kenberland/lime-scooter/img/IMG_2955.jpeg

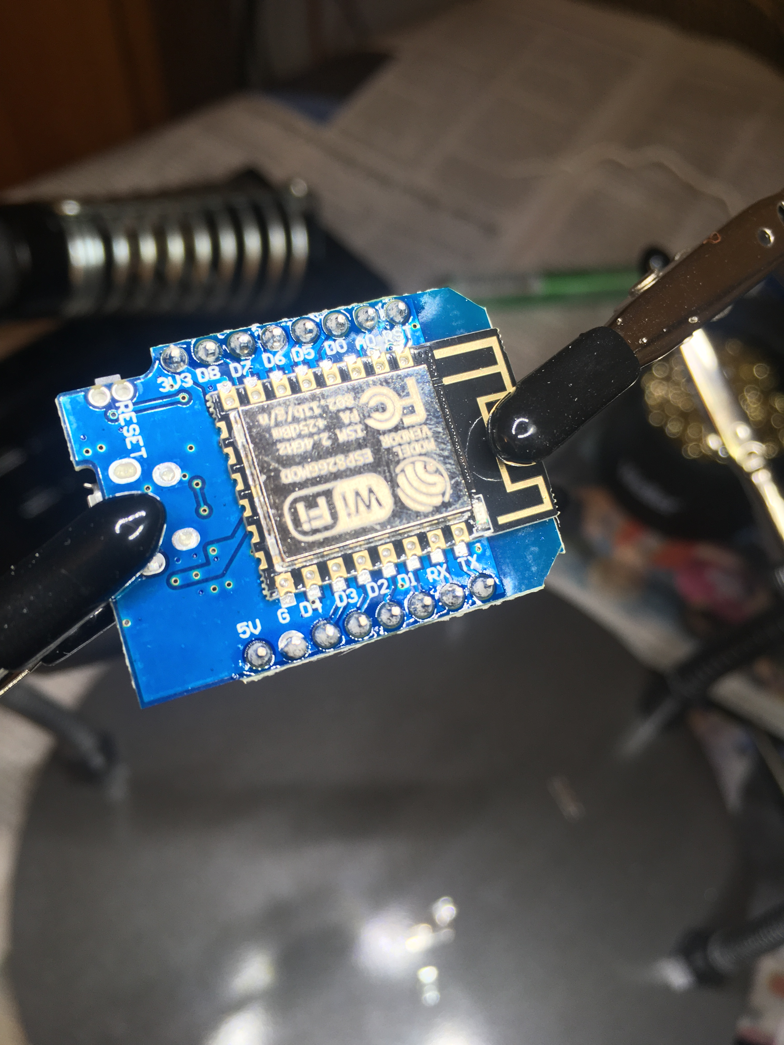
img/IMG_2955.jpeg
