kenberland/lime-scooter/img/IMG_3039.jpg

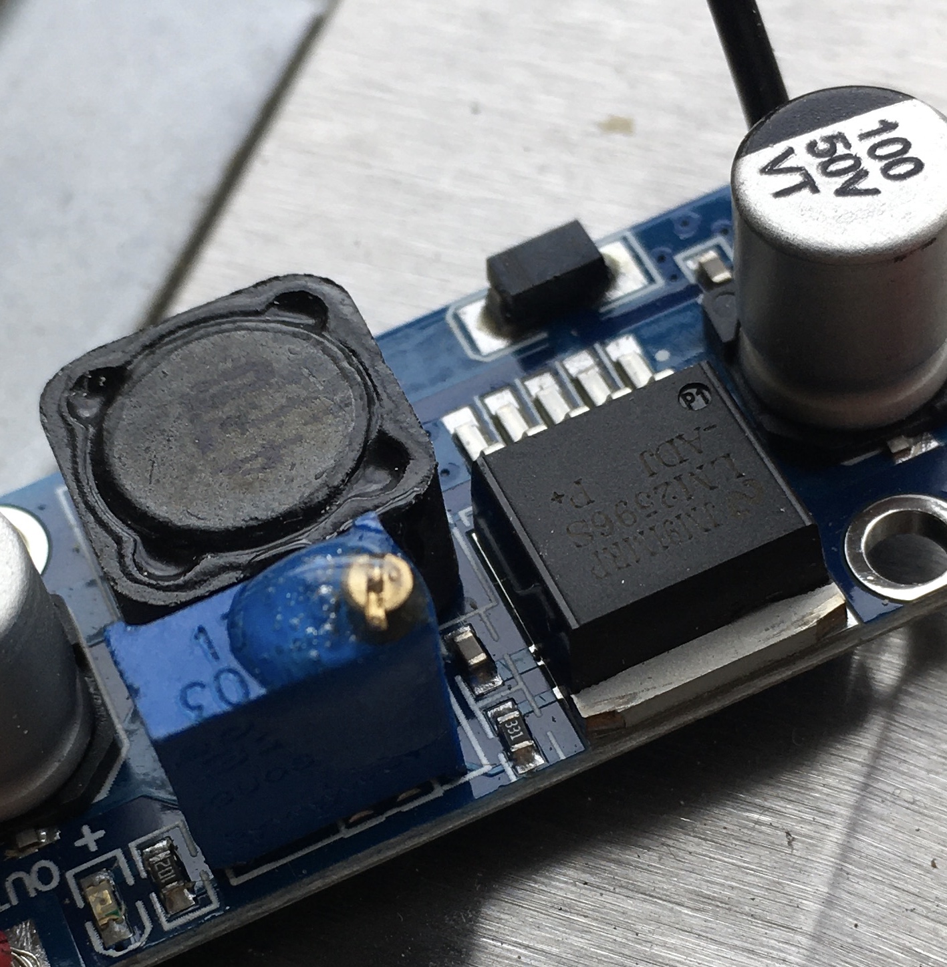
img/IMG_3039.jpg
