kenberland/lime-scooter/MCU-standoff.stl

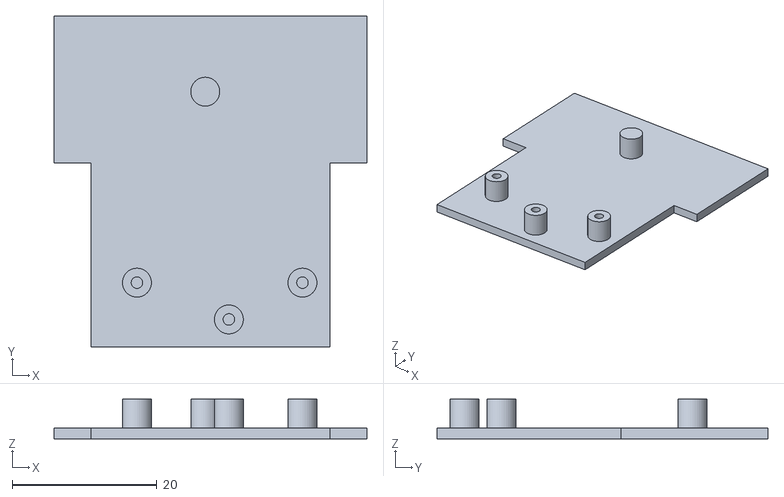
[picture p20: CAD file, 2022-08-20]
MCU-standoff.stl
43.2 x 45.7 x 5.50
