kenberland/lime-scooter/lime-display.stl

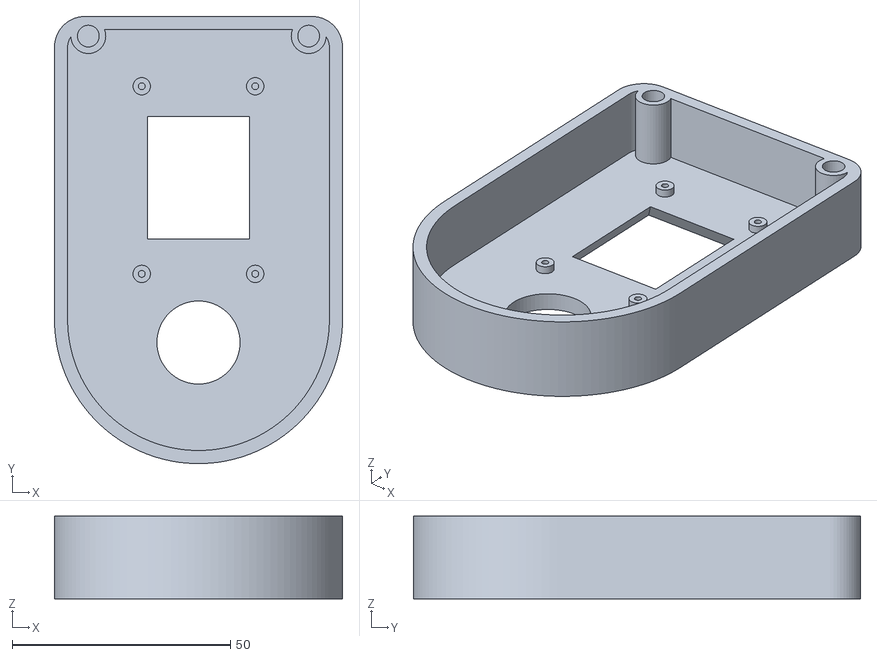
[picture p21: CAD file, 2022-08-20]
lime-display.stl
66.0 x 102.5 x 19.0
