kenberland/lime-scooter/lens.stl

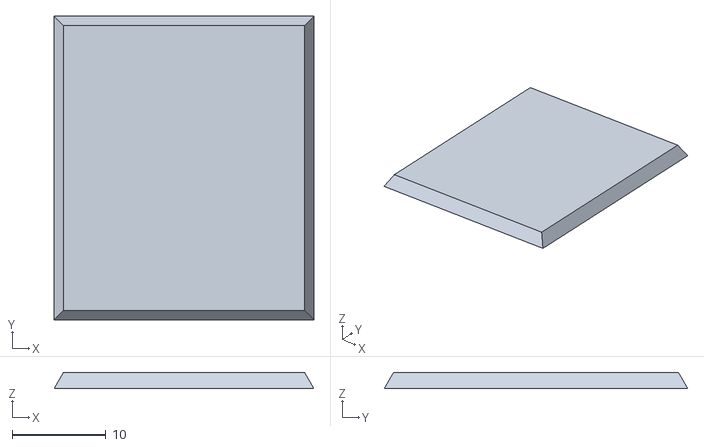
[picture p22: CAD file, 2022-08-20]
lens.stl
27.7 x 32.3 x 1.75
