kenberland/lime-scooter/power-supply-housing.stl

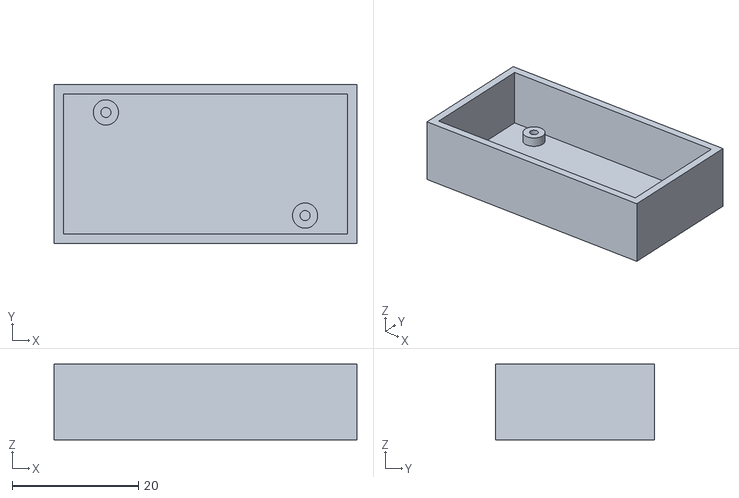
[picture p23: CAD file, 2022-08-20]
power-supply-housing.stl
48.0 x 25.2 x 12.0
