kenberland/lime-scooter/(list of files, cad)

Other CAD files:
MCU-standoff.f3d
lime-display.f3z
power-supply-housing.f3d
