kenberland/lime-scooter/(list of files, drawings)

Other design files:
lime.v03.fzz
