kenberland/lime-scooter/(commit log)

2022-05-23 add some BOM
2022-08-20 Add README
    [MCU-standoff.f3d, MCU-standoff.stl, lens.stl, lime-display.f3z, lime-display.stl, lime.v03.fzz, power-supply-housing.f3d, power-supply-housing.stl]
