kenberland/lime-scooter/img/67320624998__4B6C731F-94F0-454F-99B1-646DE0FB5E3A.jpeg

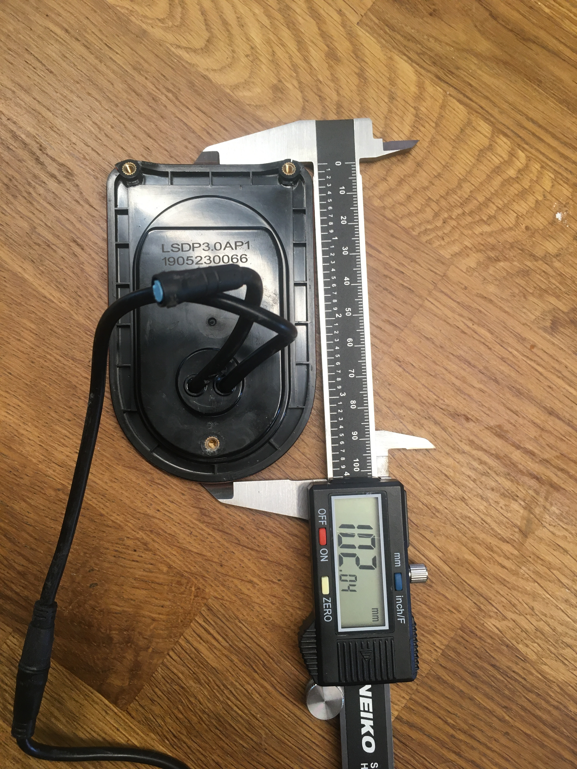
img/67320624998__4B6C731F-94F0-454F-99B1-646DE0FB5E3A.jpeg
