kenberland/lime-scooter/img/IMG_2887.jpeg

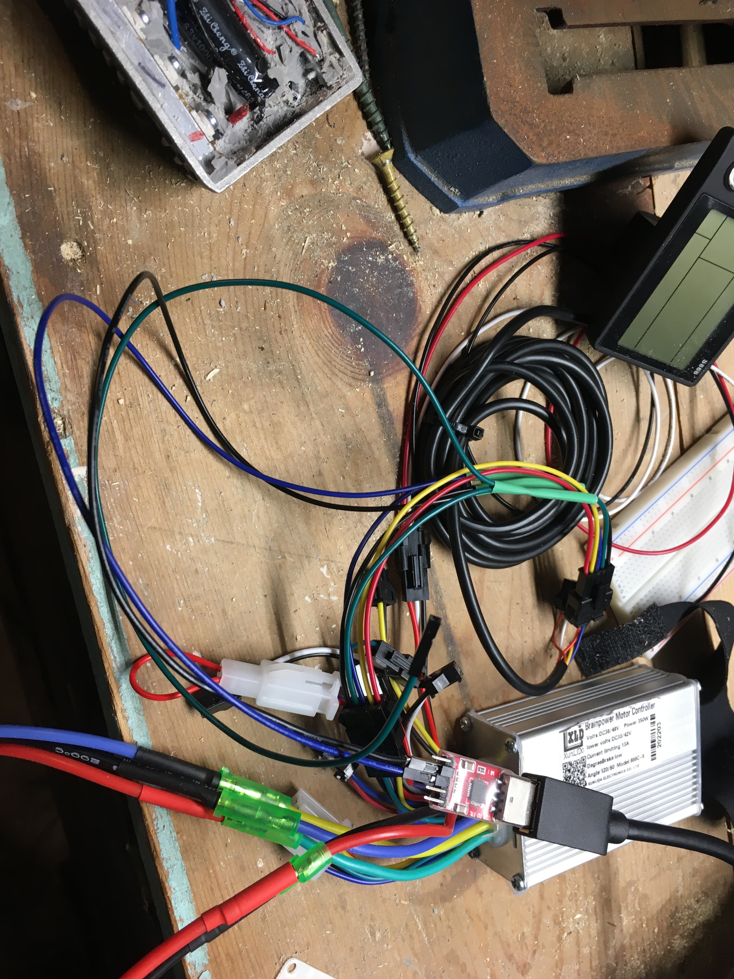
[picture p8: img/IMG_2887.jpeg]
img/IMG_2887.jpeg
