kenberland/lime-scooter/img/IMG_2890.jpeg

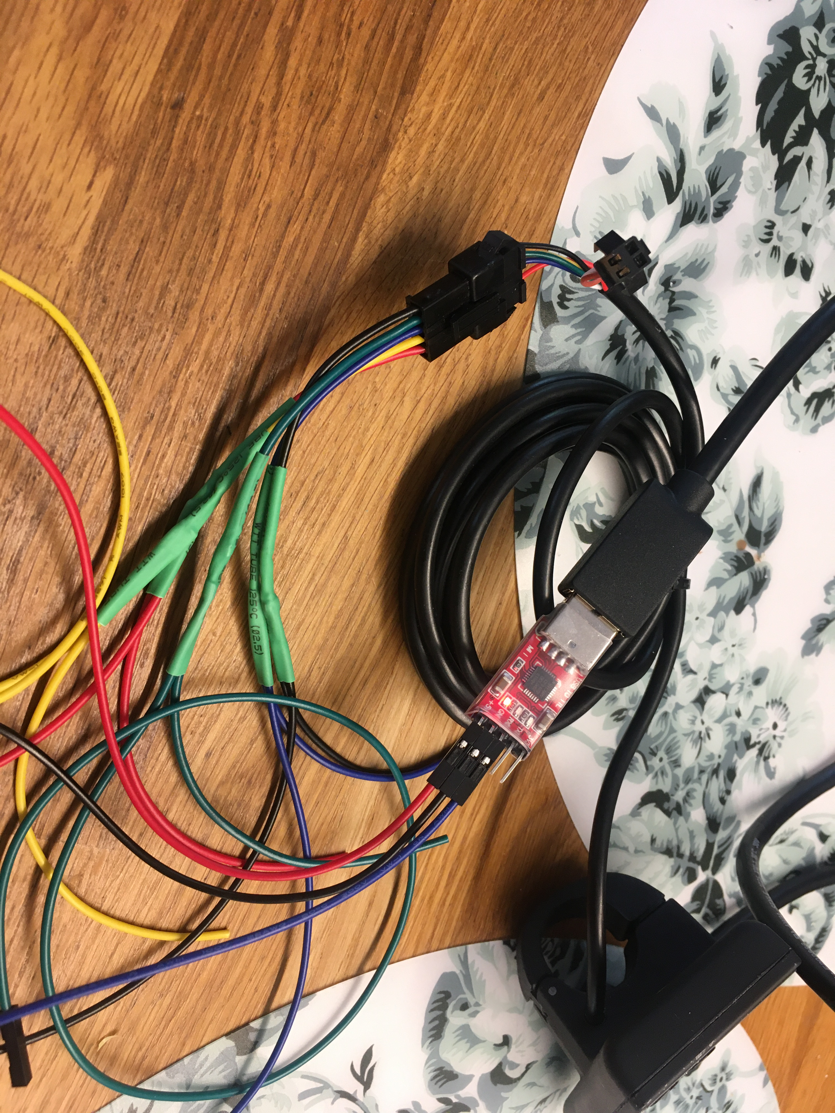
[picture p9: img/IMG_2890.jpeg]
img/IMG_2890.jpeg
