kenberland/lime-scooter/img/IMG_3112.jpeg

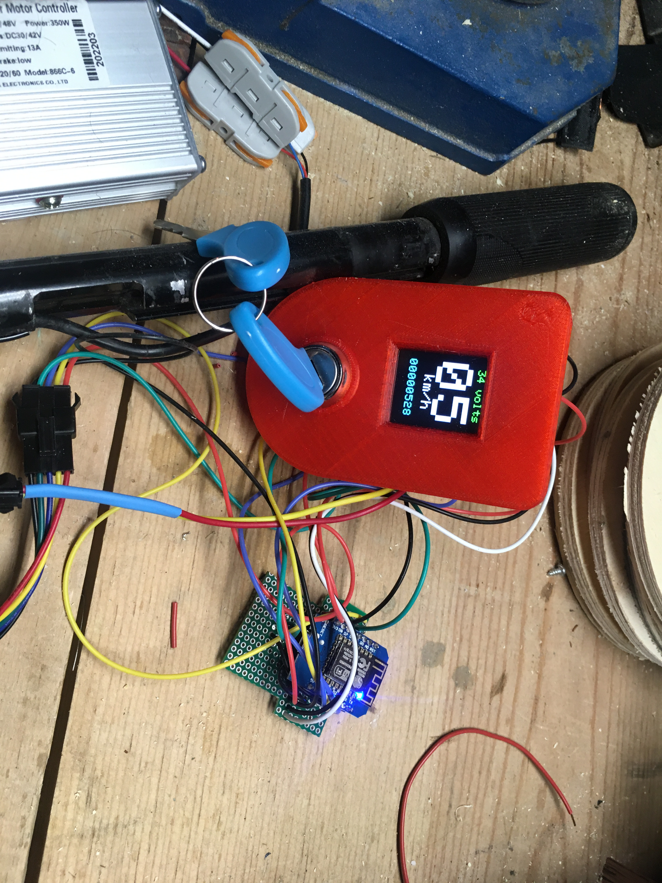
[picture p11: img/IMG_3112.jpeg]
img/IMG_3112.jpeg
