kenberland/lime-scooter/img/IMG_3149.jpeg

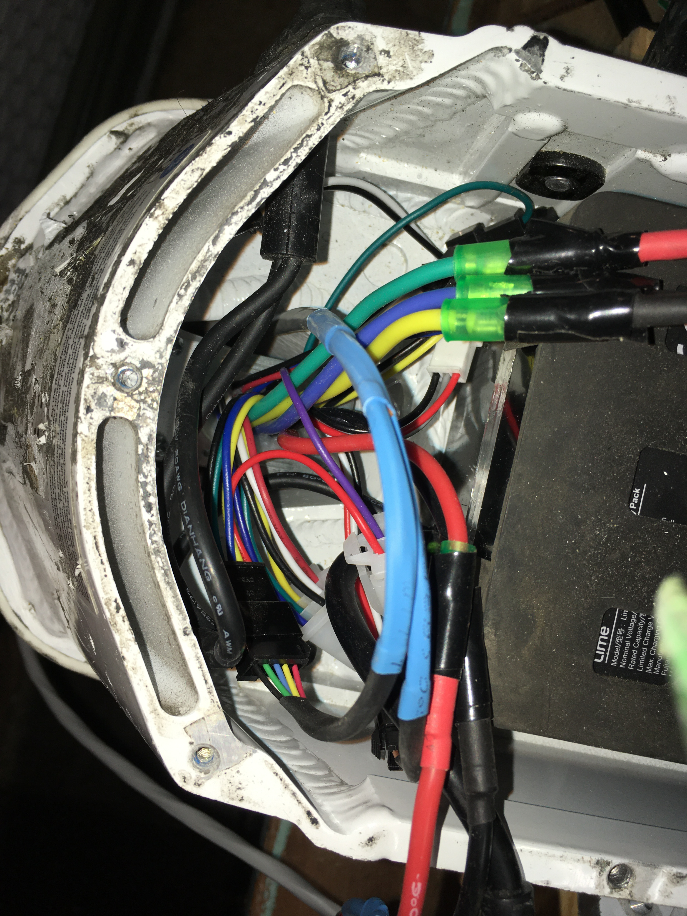
[picture p12: img/IMG_3149.jpeg]
img/IMG_3149.jpeg
