kenberland/lime-scooter/img/IMG_3151.jpeg

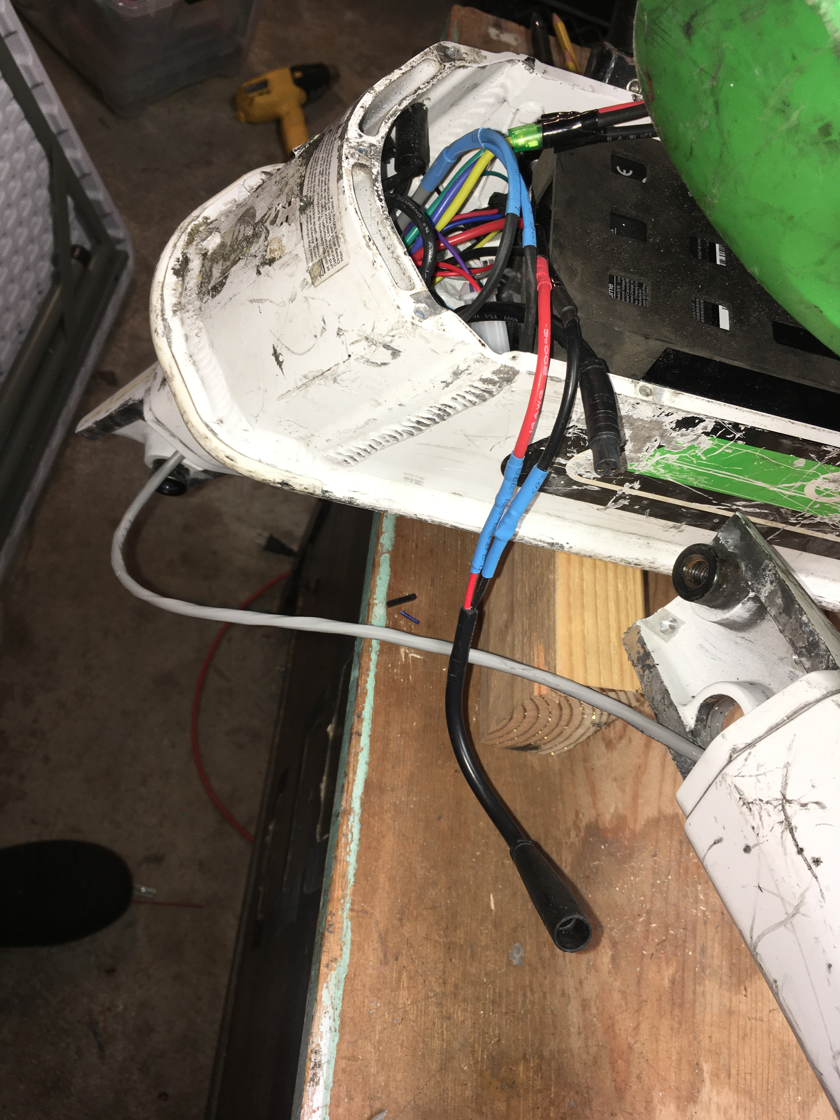
[picture p14: img/IMG_3151.jpeg]
img/IMG_3151.jpeg
